rigvedepur/receipt-scanner/feed-rig/renders/inside_view.png

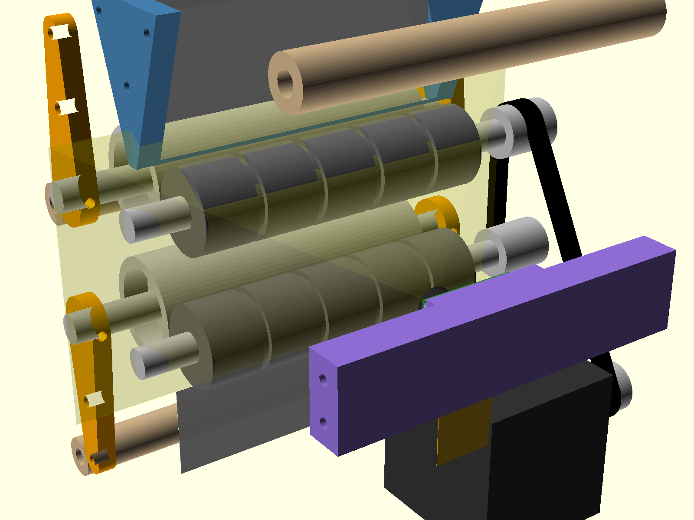
feed-rig/renders/inside_view.png
