rigvedepur/receipt-scanner/feed-rig/renders/camera_mount.png

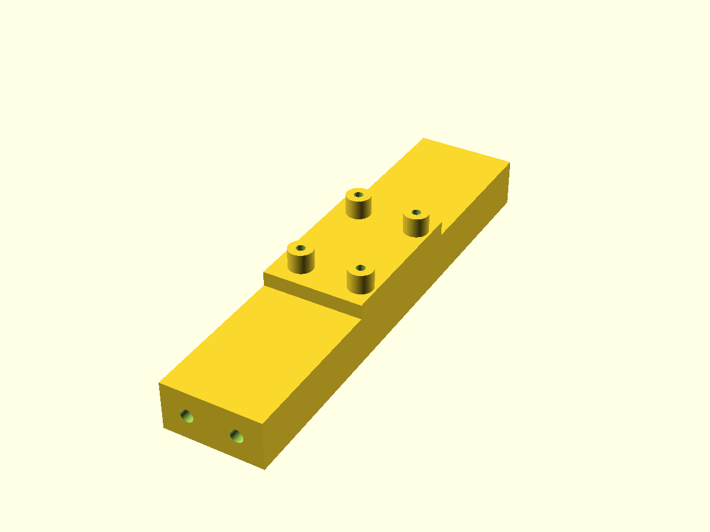
feed-rig/renders/camera_mount.png
