rigvedepur/receipt-scanner/feed-rig/renders/camera_mount_laser.png

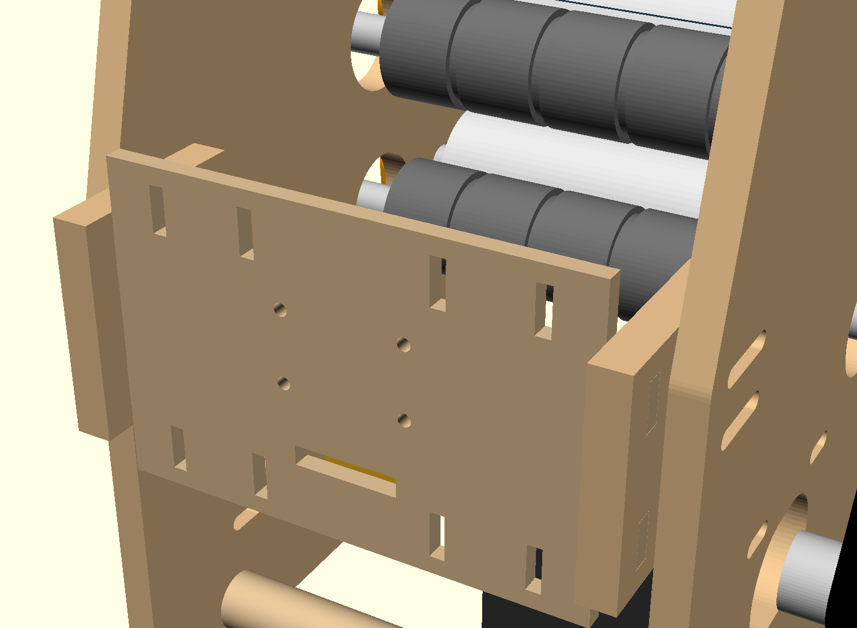
feed-rig/renders/camera_mount_laser.png
