rigvedepur/receipt-scanner/feed-rig/renders/camera_mount_laser_side.png

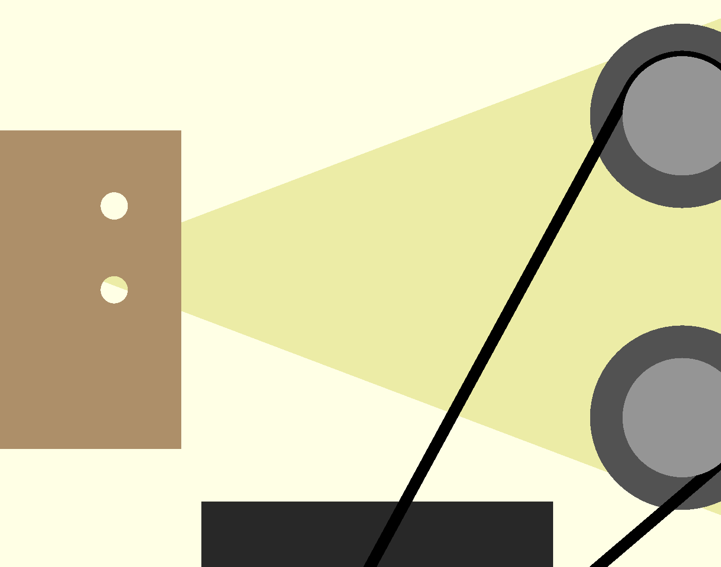
feed-rig/renders/camera_mount_laser_side.png
