rigvedepur/receipt-scanner/feed-rig/renders/cnc_toolpaths.png

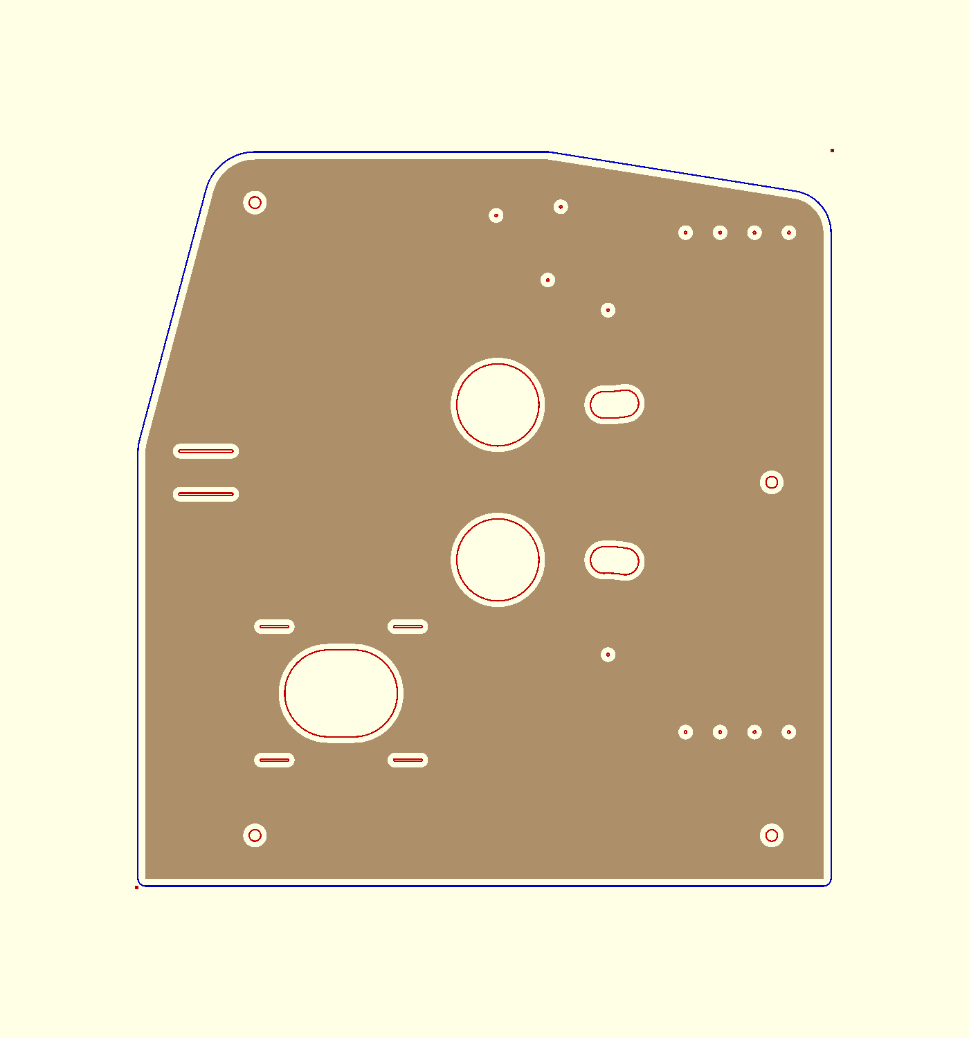
feed-rig/renders/cnc_toolpaths.png
