rigvedepur/receipt-scanner/feed-rig/renders/drive_detail_exploded.png

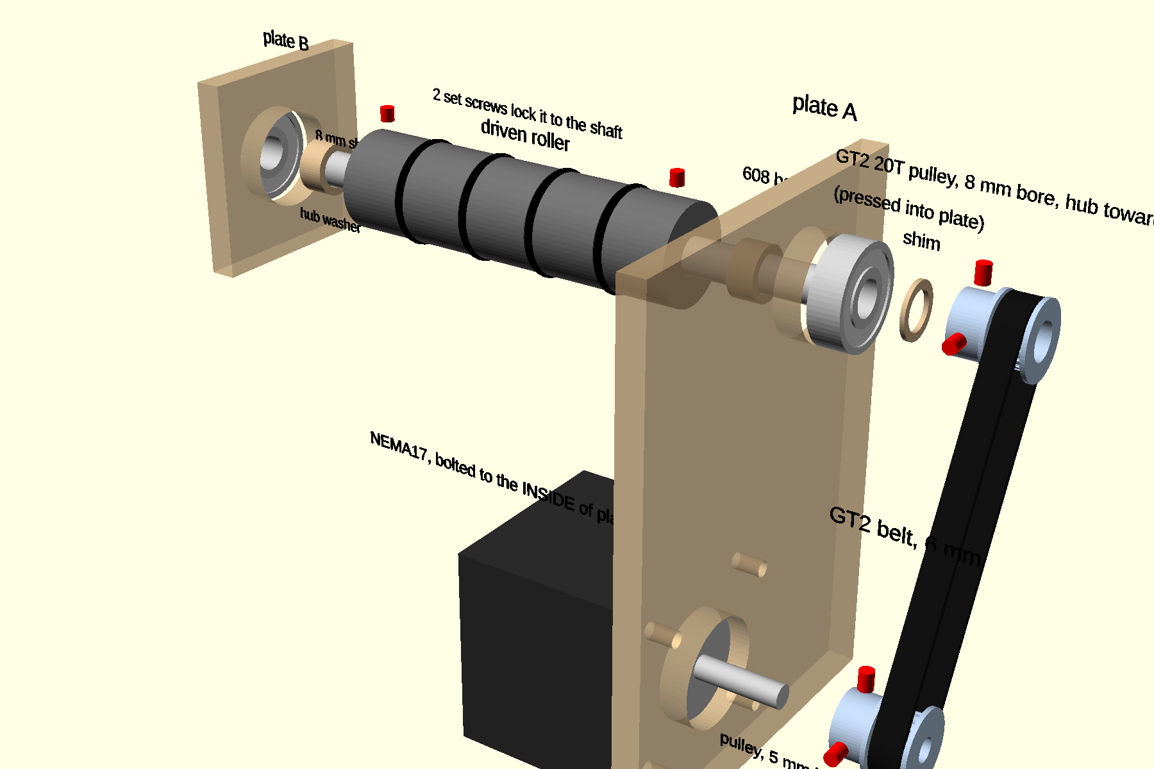
feed-rig/renders/drive_detail_exploded.png
