rigvedepur/receipt-scanner/feed-rig/renders/fit_coupon.png

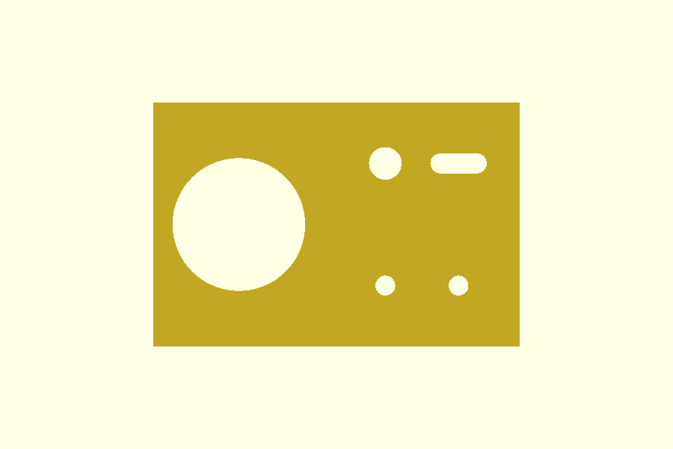
feed-rig/renders/fit_coupon.png
