rigvedepur/receipt-scanner/feed-rig/renders/idler_demos/idler_common_gallery.png

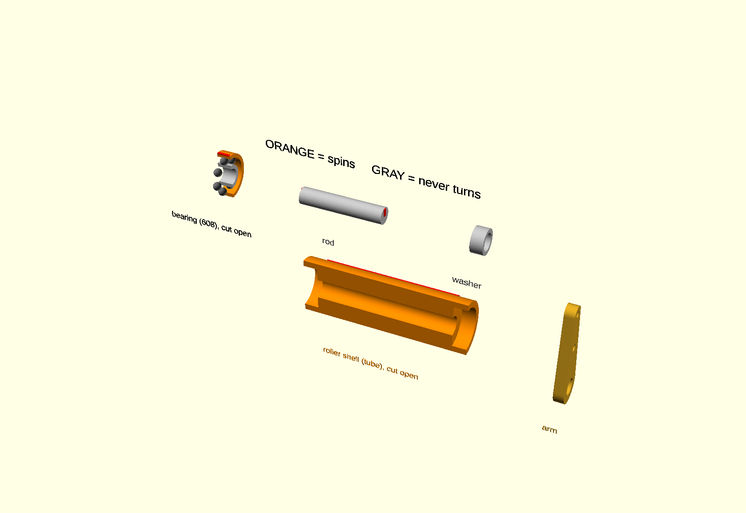
feed-rig/renders/idler_demos/idler_common_gallery.png
