rigvedepur/receipt-scanner/feed-rig/renders/idler_demos/idler_demo1_bearing.png

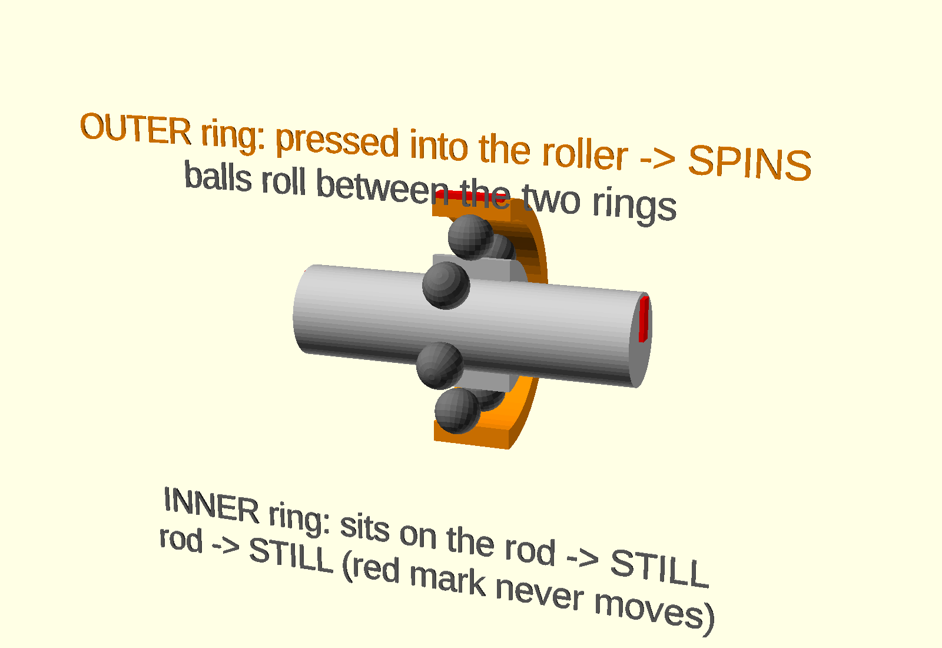
feed-rig/renders/idler_demos/idler_demo1_bearing.png
