rigvedepur/receipt-scanner/feed-rig/renders/idler_demos/idler_demo2_roller.png

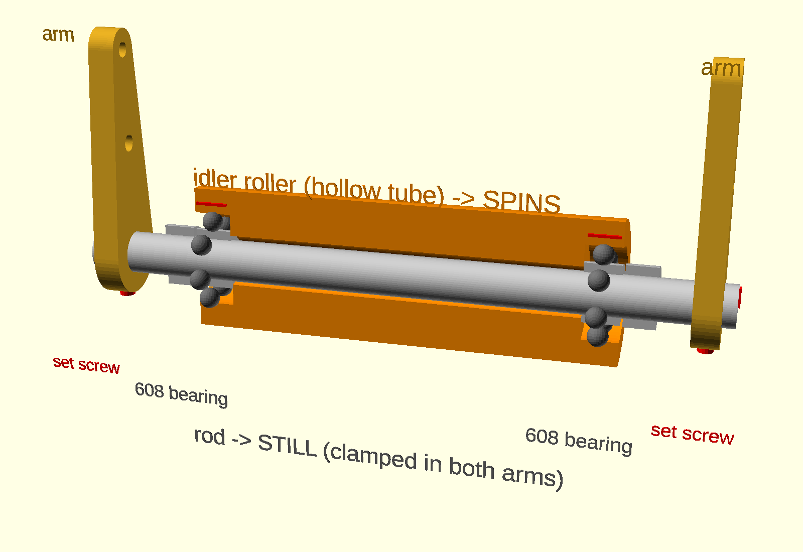
feed-rig/renders/idler_demos/idler_demo2_roller.png
