rigvedepur/receipt-scanner/feed-rig/renders/idler_demos/idler_demo3_section.png

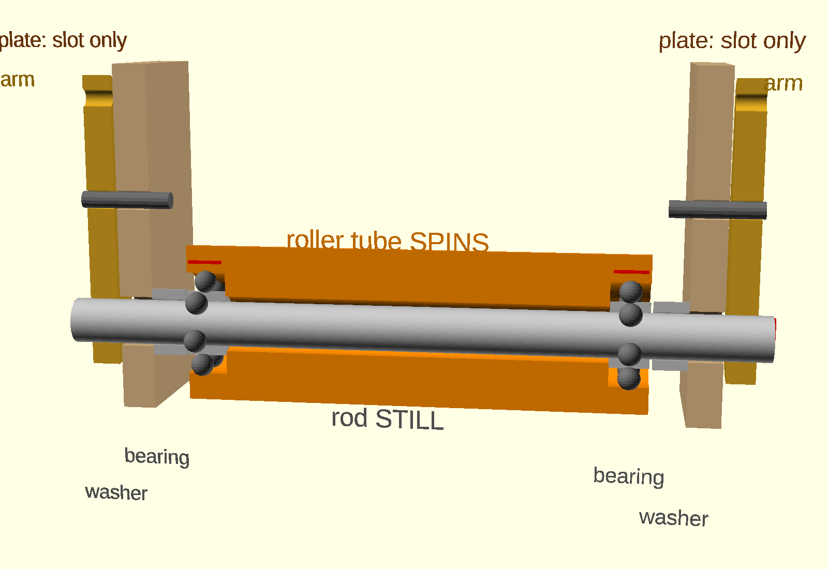
feed-rig/renders/idler_demos/idler_demo3_section.png
