rigvedepur/receipt-scanner/feed-rig/renders/idler_demos/idler_demo4_swing.png

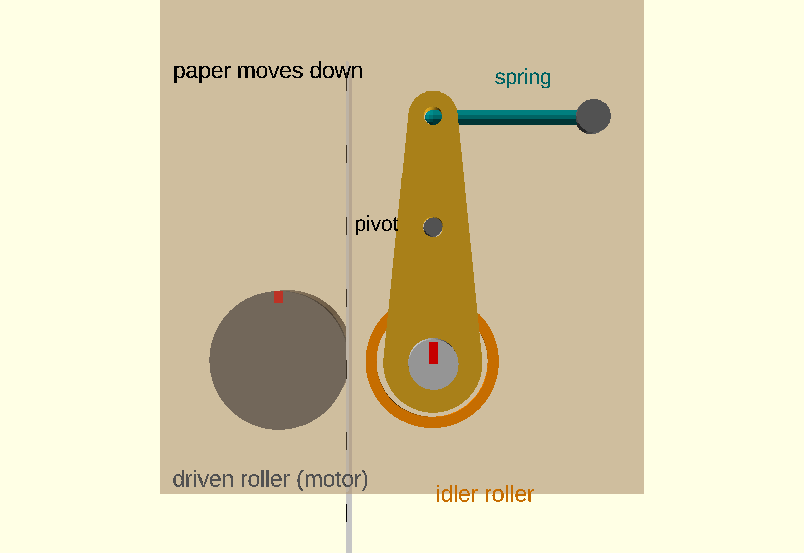
feed-rig/renders/idler_demos/idler_demo4_swing.png
