rigvedepur/receipt-scanner/feed-rig/renders/idler_detail.png

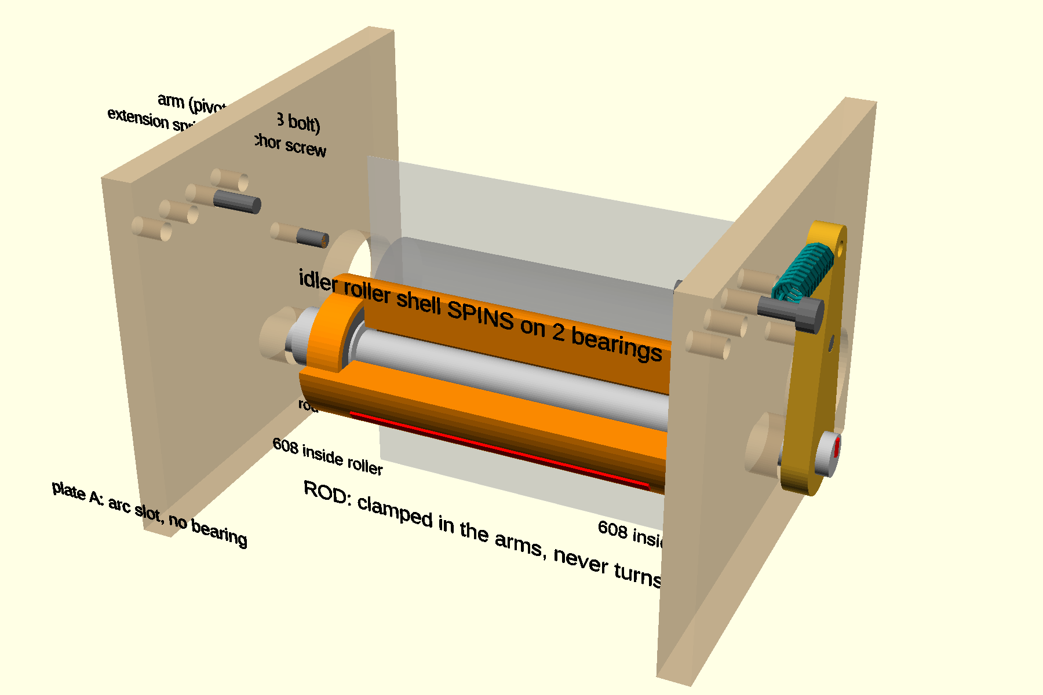
feed-rig/renders/idler_detail.png
