rigvedepur/receipt-scanner/feed-rig/renders/idler_detail_exploded.png

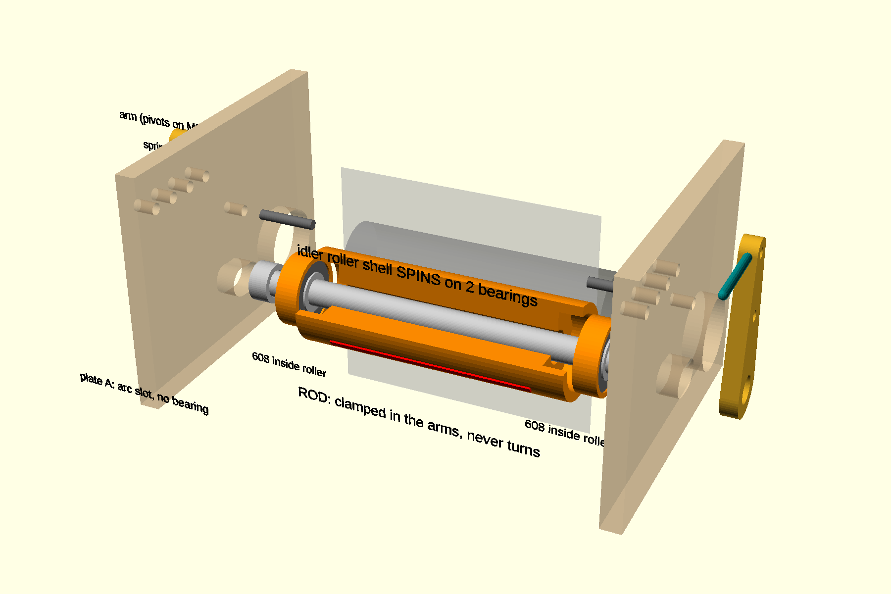
feed-rig/renders/idler_detail_exploded.png
