rigvedepur/receipt-scanner/feed-rig/renders/idler_detail_open_endview.png

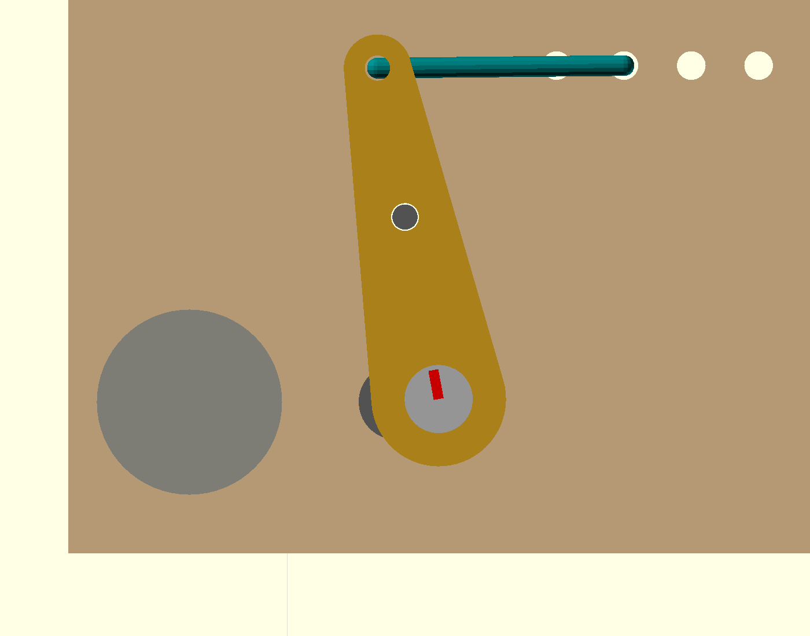
feed-rig/renders/idler_detail_open_endview.png
