rigvedepur/receipt-scanner/feed-rig/renders/idler_spring_closeup.png

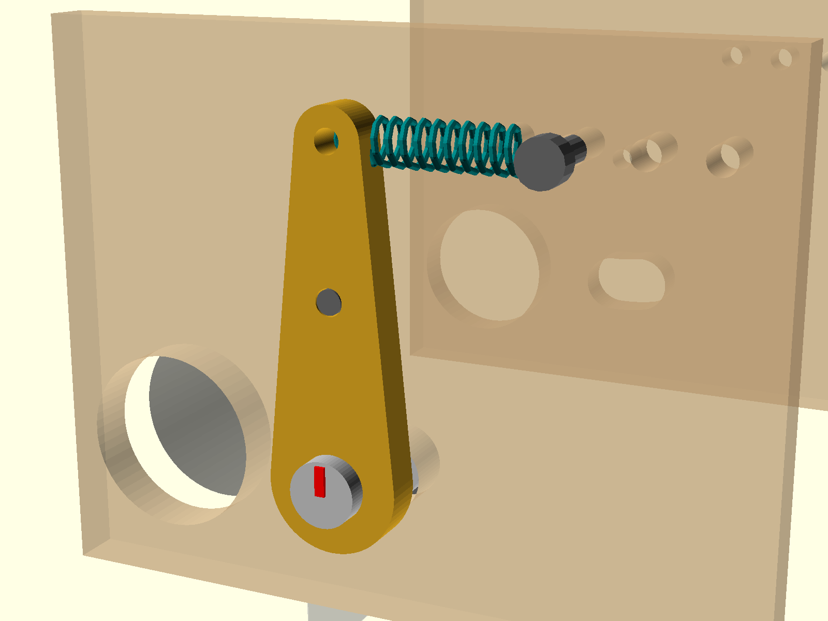
feed-rig/renders/idler_spring_closeup.png
