rigvedepur/receipt-scanner/feed-rig/renders/paper_path_diagram.png

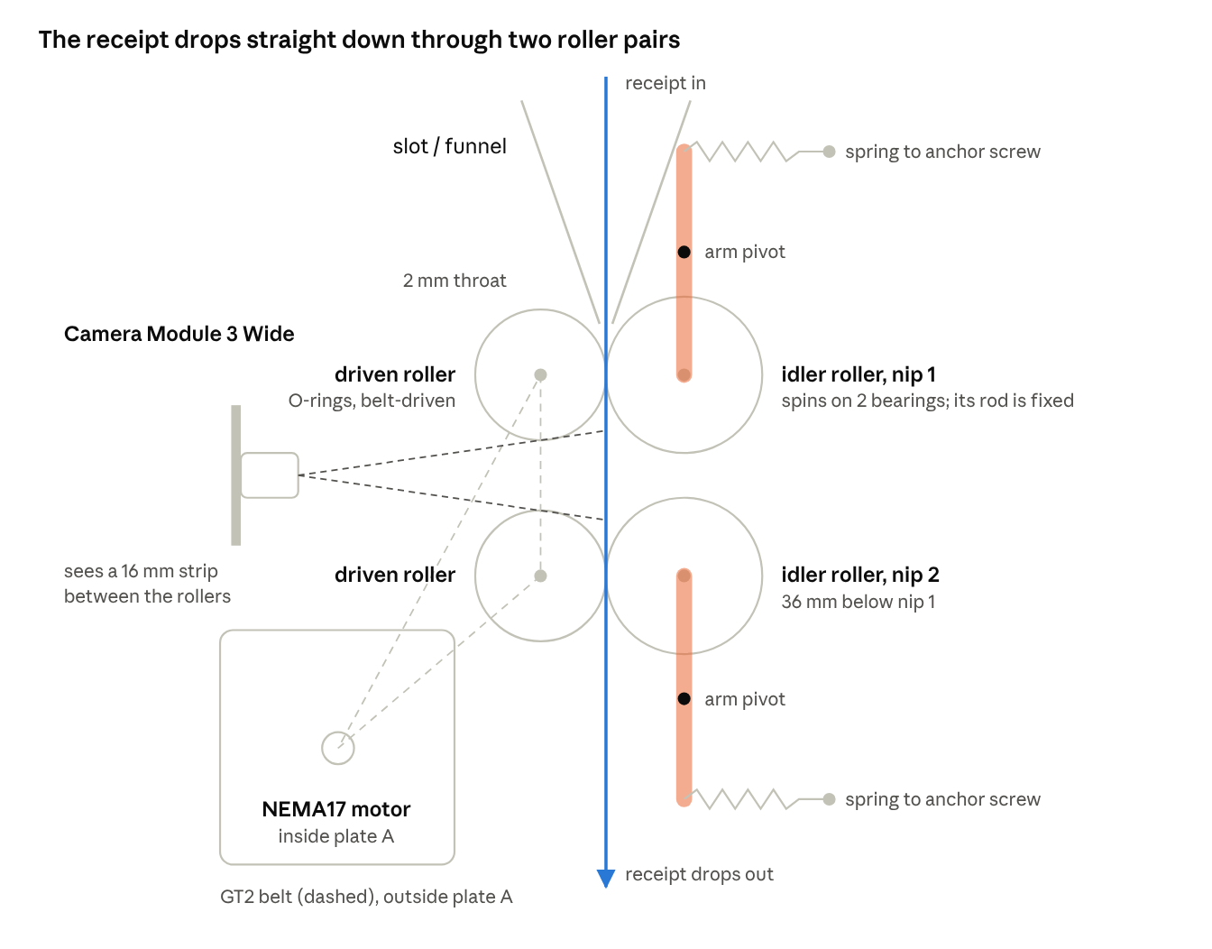
feed-rig/renders/paper_path_diagram.png
