rigvedepur/receipt-scanner/feed-rig/renders/side_view_camera_los.png

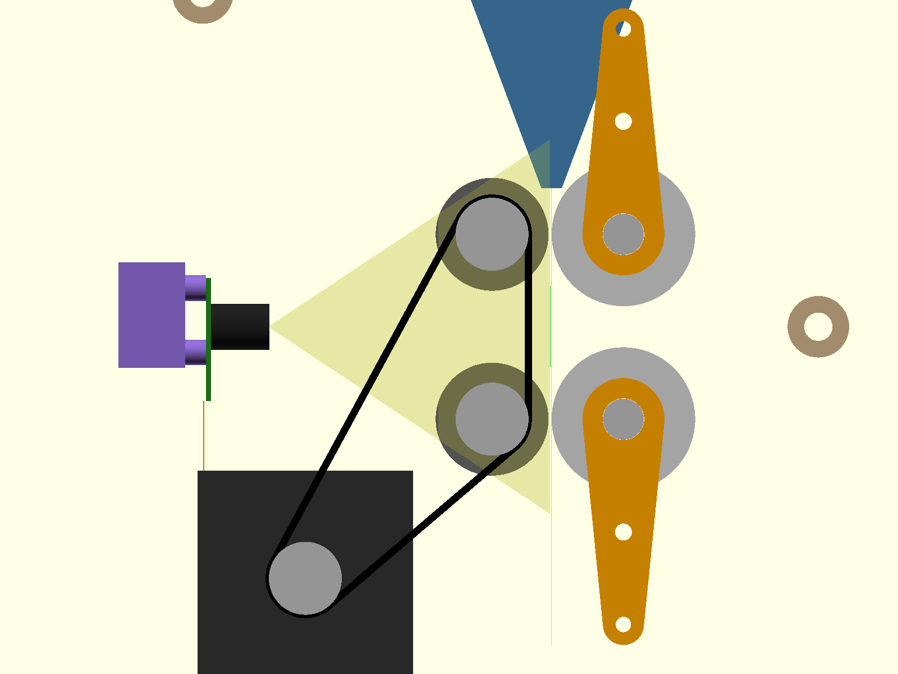
feed-rig/renders/side_view_camera_los.png
