rigvedepur/receipt-scanner/feed-rig/renders/side_view_with_arms.png

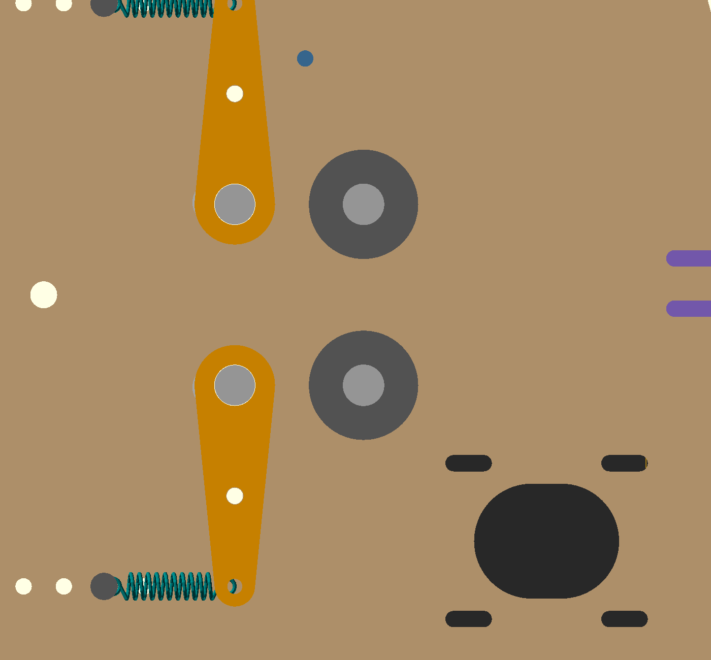
feed-rig/renders/side_view_with_arms.png
