rigvedepur/receipt-scanner/feed-rig/stl/idler_roller.stl

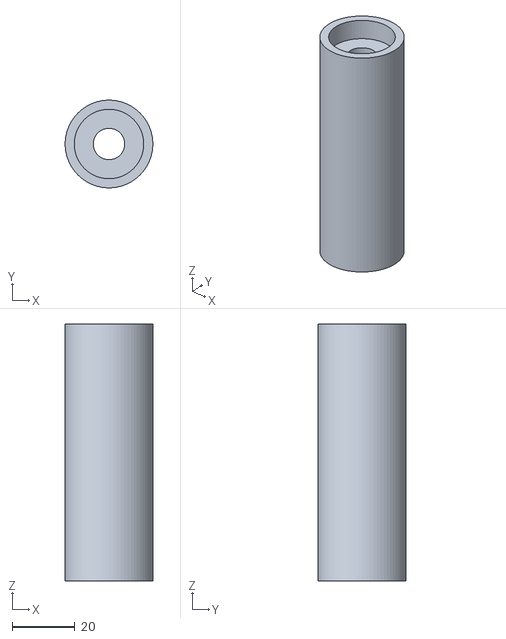
[picture p20: CAD file, 2026-10-03]
feed-rig/stl/idler_roller.stl
28.0 x 28.0 x 82.0
