rigvedepur/receipt-scanner/feed-rig/stl/side_plate.stl

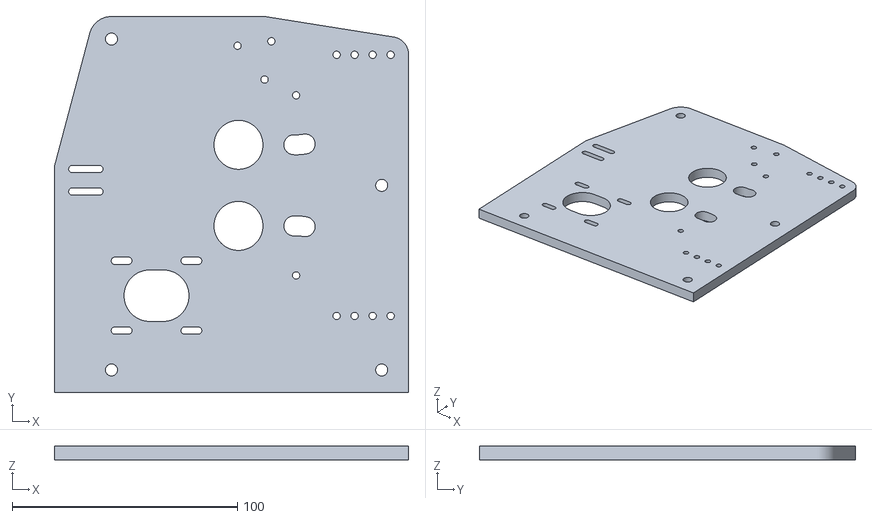
[picture p21: CAD file, 2026-10-03]
feed-rig/stl/side_plate.stl
157.4 x 167.0 x 6.00
