rigvedepur/receipt-scanner/feed-rig/stl/idler_arm.stl

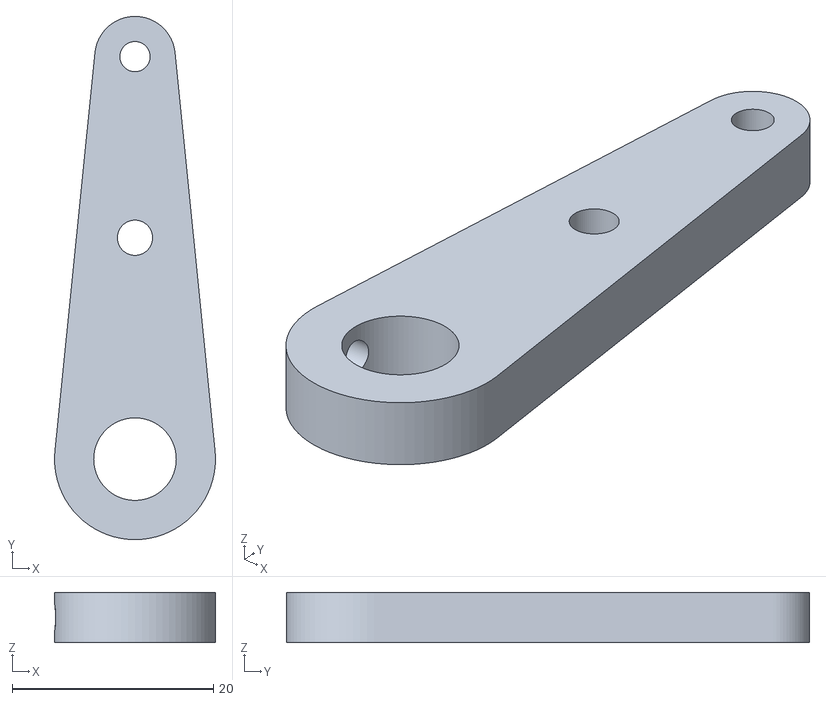
[picture p22: CAD file, 2026-10-03]
feed-rig/stl/idler_arm.stl
16.0 x 52.0 x 5.00
