rigvedepur/receipt-scanner/feed-rig/stl/driven_roller.stl

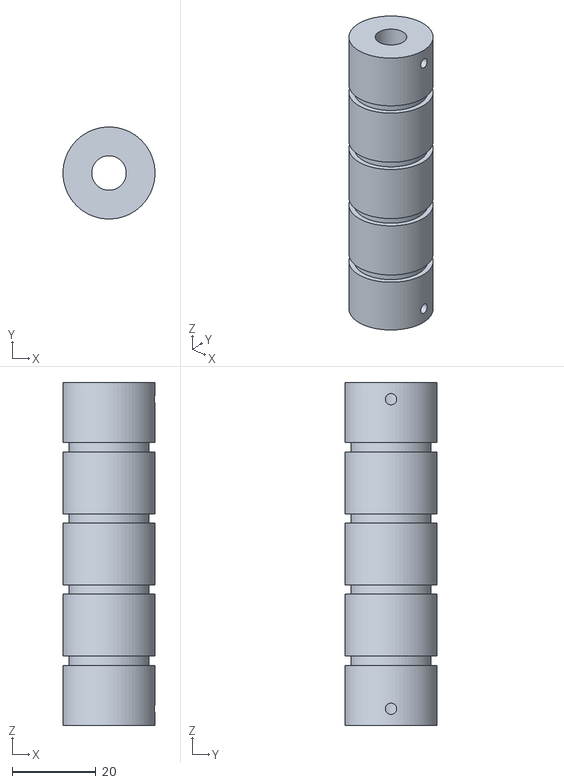
[picture p23: CAD file, 2026-10-03]
feed-rig/stl/driven_roller.stl
22.0 x 22.0 x 82.0
