rigvedepur/receipt-scanner/feed-rig/stl/camera_mount.stl

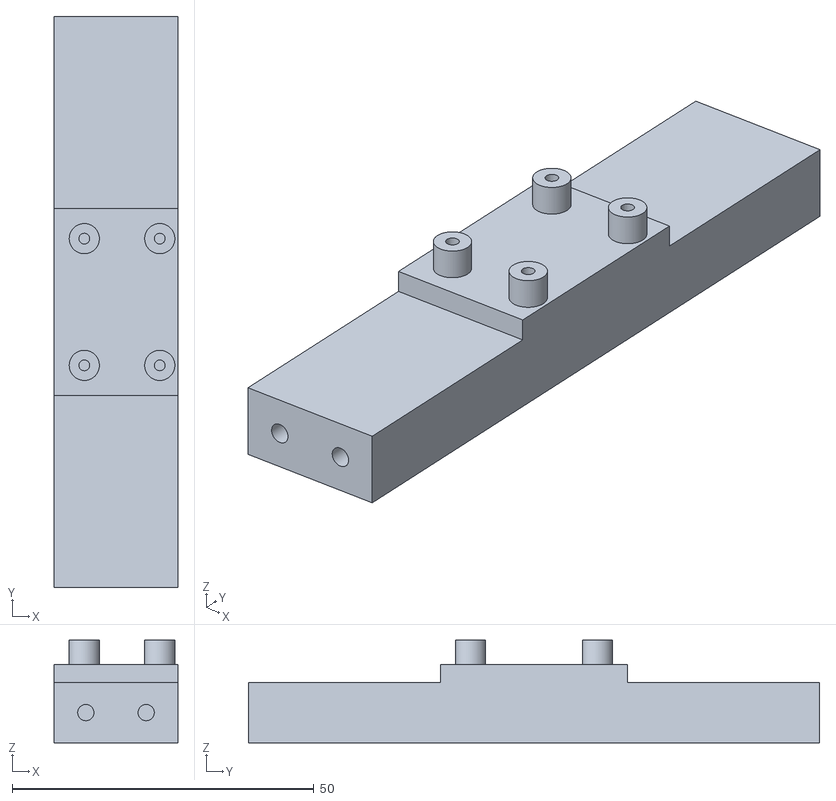
[picture p24: CAD file, 2026-10-03]
feed-rig/stl/camera_mount.stl
20.5 x 94.6 x 17.0
