rigvedepur/receipt-scanner/feed-rig/stl/pulley_shim.stl

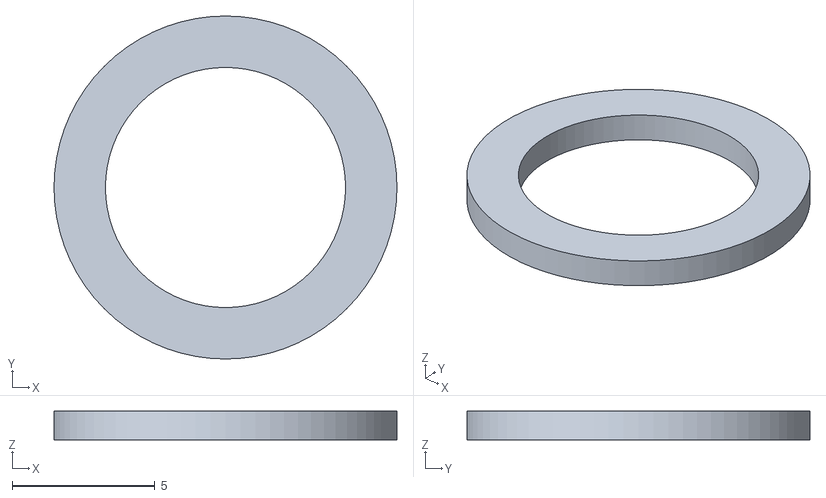
[picture p25: CAD file, 2026-10-03]
feed-rig/stl/pulley_shim.stl
12.0 x 12.0 x 1.00
