rigvedepur/receipt-scanner/feed-rig/stl/spacer.stl

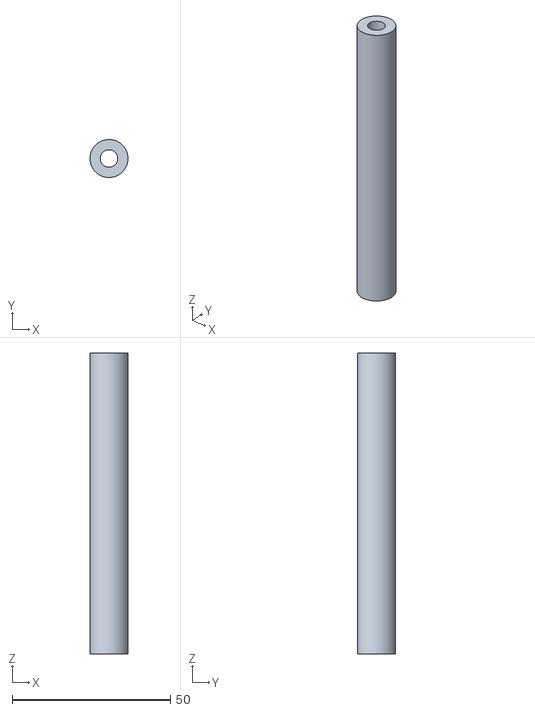
[picture p26: CAD file, 2026-10-03]
feed-rig/stl/spacer.stl
12.0 x 12.0 x 95.0
