rigvedepur/receipt-scanner/feed-rig/stl/funnel.stl

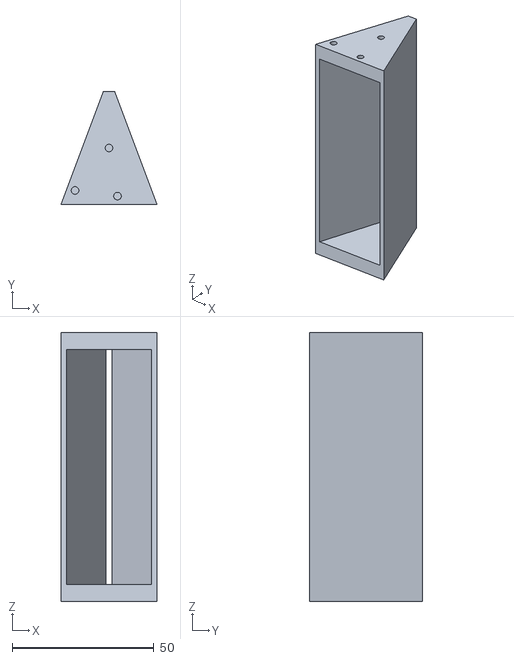
[picture p27: CAD file, 2026-10-03]
feed-rig/stl/funnel.stl
34.0 x 40.0 x 95.0
