rigvedepur/receipt-scanner/feed-rig/stl/width_shim.stl

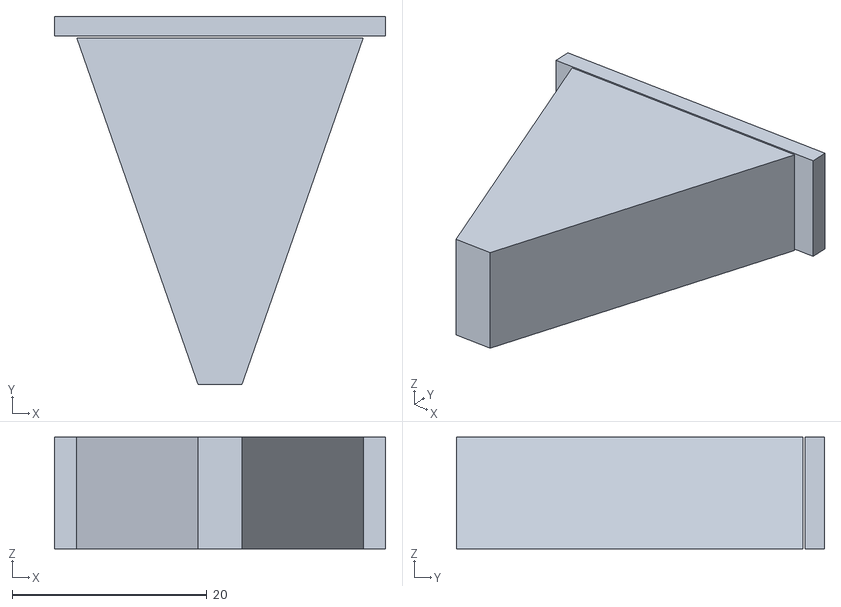
[picture p28: CAD file, 2026-10-03]
feed-rig/stl/width_shim.stl
34.0 x 37.8 x 11.5
