rigvedepur/receipt-scanner/feed-rig/stl/hub_washer.stl

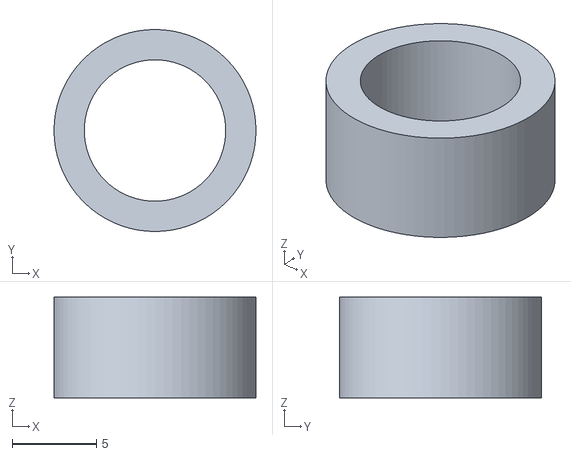
[picture p29: CAD file, 2026-10-03]
feed-rig/stl/hub_washer.stl
12.0 x 12.0 x 6.00
