rigvedepur/receipt-scanner/feed-rig/renders/assembly.png

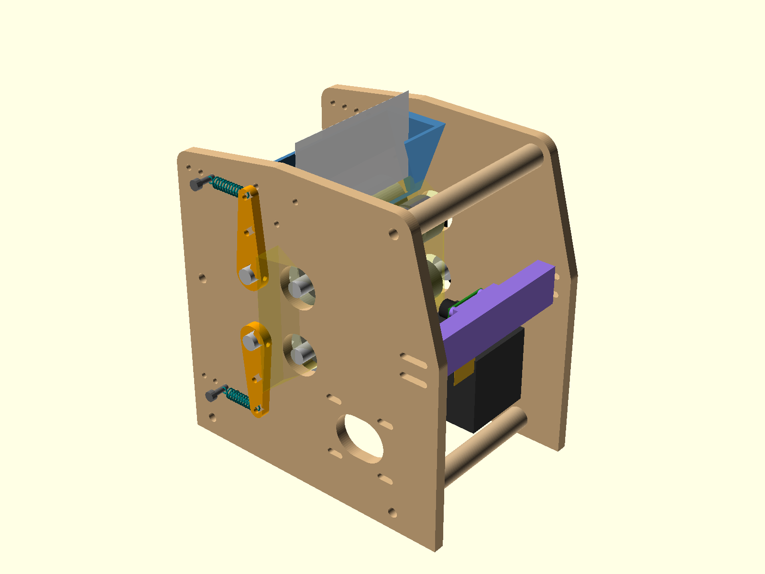
feed-rig/renders/assembly.png
