rigvedepur/receipt-scanner/feed-rig/renders/drive_detail_assembled.png

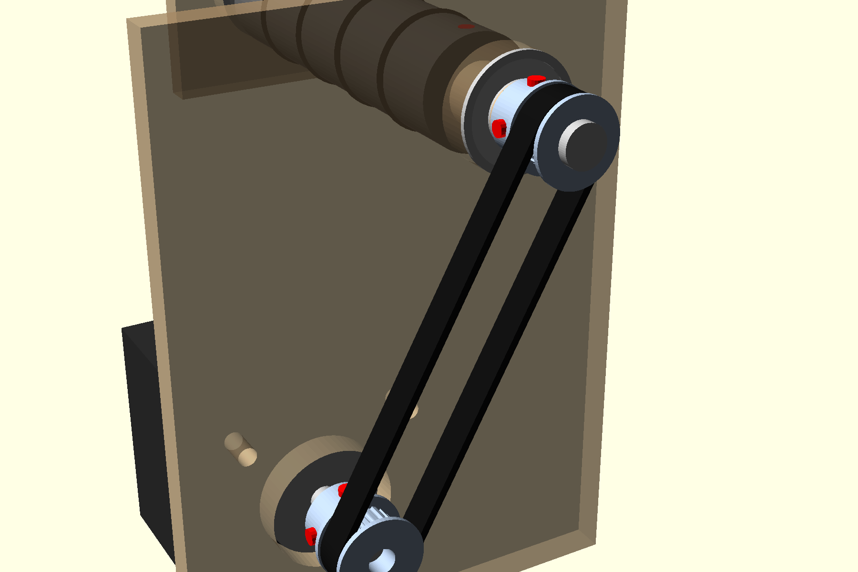
feed-rig/renders/drive_detail_assembled.png
