rigvedepur/receipt-scanner/(commit log)

2026-10-04 modified for using a single drill bit case
    [bom.csv, drive_detail.scad, feed_rig.scad]
2026-10-04 modify bom and instructions
    [bom.csv]
2026-10-21 add some more cut files and stepper code
